heliflieger/Jeti_VarioGPS-Sensor/Arduino/VarioGPS_Sensor/defaults.h

#define MEASURING_INTERVAL        180         //ms
enum
{
  P_GPS_MODE =              1,
  P_GPS_3D =                2,
  P_CURRENT_SENSOR =        3,
  P_CURRENT_CALIBRATION =   4,
  P_CAPACITY_MODE =         5,
  P_ENABLE_RX1 =            6,
  P_ENABLE_RX2 =            7,
  P_ENABLE_TEMP =           8,
  P_ENABLE_COMPASS =        9,
  P_ENABLE_TRAINING =      10,
  P_VARIO_SMOOTHING =      12,
  P_VARIO_DEADZONE =       14,
  P_VARIO_SEALEVELPRESSURE =       15, // 4 Bytes
  P_AIRSPEED_SENSOR =      19,
  P_TEC_MODE =             20,
  P_CAPACITY_VALUE =       26,
  P_VOLTAGE_VALUE =        P_CAPACITY_VALUE+sizeof(float)
};
enum
{
  ID_GPSLAT = 1,
  ID_GPSLON,
  ID_GPSSPEED,
  ID_ALTREL,
  ID_ALTABS,
  ID_VARIO,
  ID_DIST,
  ID_TRIP,
  ID_AZIMUTH,
  ID_COURSE,
  ID_SATS,
  ID_HDOP,
  ID_PRESSURE,
  ID_TEMPERATURE,
  ID_HUMIDITY,
  ID_VOLTAGE,
  ID_CURRENT,
  ID_CAPACITY,
  ID_POWER,
  ID_RX1_VOLTAGE,
  ID_RX2_VOLTAGE,
  ID_EXT_TEMP,
  ID_AIRSPEED,
  ID_SV_SIG_LOSS_CNT,
  ID_SV_SIGNAL_GAP,
  ID_SV_SIGNAL_GAP_MAX,
  ID_SV_SIGNALS_PER_SECOND,
  #ifdef SUPPORT_LSM303
  ID_COMPASS,
  ID_REL_COMPASS,
  ID_TRAINING_ORIENTATION,
  ID_TRAINING_ALTIT,
  #endif
  ID_LAST // not used, but has to be <=32 (see JetiExProtocol.h : MAX_SENSORS)
};
#define RXQ_SIGNAL_PIN 2
#ifndef UNIT_US
JETISENSOR_CONST sensors[] PROGMEM =
{
  #ifdef SUPPORT_GPS
  { ID_GPSLAT,      "Latitude",   " ",          JetiSensor::TYPE_GPS, 0 },
  { ID_GPSLON,      "Longitude",  " ",          JetiSensor::TYPE_GPS, 0 },
  { ID_GPSSPEED,    "GPS speed",  "km/h",       JetiSensor::TYPE_14b, 0 },
  { ID_DIST,        "Distance",   "m",          JetiSensor::TYPE_22b, 0 },
  #ifdef SUPPORT_GPS_EXTENDED
  { ID_TRIP,        "Trip",       "km",         JetiSensor::TYPE_22b, 2 },
  { ID_AZIMUTH,     "Azimuth",    "\xB0",       JetiSensor::TYPE_14b, 0 },
  { ID_COURSE,      "Course",     "\xB0",       JetiSensor::TYPE_14b, 0 },
  { ID_SATS,        "Satellites", " ",          JetiSensor::TYPE_6b,  0 },
  { ID_HDOP,        "HDOP",       " ",          JetiSensor::TYPE_14b, 2 },
  #endif
  #endif
  { ID_ALTREL,      "Rel. Altit", "m",          JetiSensor::TYPE_22b, 1 },
  { ID_ALTABS,      "Abs. Altit", "m",          JetiSensor::TYPE_22b, 0 },
  { ID_VARIO,       "Variometer", "m/s",        JetiSensor::TYPE_22b, 2 },
  { ID_PRESSURE,    "Air press.", "hPa",        JetiSensor::TYPE_22b, 2 },
  { ID_TEMPERATURE, "Temp.",      "\xB0\x43",   JetiSensor::TYPE_14b, 1 },
  #ifdef SUPPORT_BMx280
  { ID_HUMIDITY,    "Humidity",   "%rH",        JetiSensor::TYPE_14b, 1 },
  #endif
  #ifdef SUPPORT_MAIN_DRIVE
  { ID_VOLTAGE,     "Voltage",    "V",          JetiSensor::TYPE_14b, 1 },
  { ID_CURRENT,     "Current",    "A",          JetiSensor::TYPE_14b, 1 },
  { ID_CAPACITY,    "Capacity",   "mAh",        JetiSensor::TYPE_22b, 0 },
  { ID_POWER,       "Power",      "W",          JetiSensor::TYPE_22b, 0 },
  #endif
  #ifdef SUPPORT_RX_VOLTAGE
  { ID_RX1_VOLTAGE, "Rx1 Voltage","V",          JetiSensor::TYPE_14b, 2 },
  { ID_RX2_VOLTAGE, "Rx2 Voltage","V",          JetiSensor::TYPE_14b, 2 },
  #endif
  #ifdef SUPPORT_EXT_TEMP
  { ID_EXT_TEMP,    "Ext. Temp",  "\xB0\x43",   JetiSensor::TYPE_14b, 1 },
  #endif
  #ifdef SUPPORT_MPXV7002_MPXV5004
  { ID_AIRSPEED,    "Air speed",  "km/h",       JetiSensor::TYPE_14b, 0 },
  #endif
  #ifdef SUPPORT_RXQ
  { ID_SV_SIG_LOSS_CNT, "SigLossCnt", "#",      JetiSensor::TYPE_14b, 0 },
  { ID_SV_SIGNAL_GAP,  "SigGap","ms",           JetiSensor::TYPE_22b, 0 },
  { ID_SV_SIGNAL_GAP_MAX,  "SigGapMax","ms",    JetiSensor::TYPE_22b, 0 },
  { ID_SV_SIGNALS_PER_SECOND, "#Sig/Sec","#",   JetiSensor::TYPE_14b, 0 },
  #endif
  #ifdef SUPPORT_LSM303
  { ID_COMPASS,     "Compass",     "\xB0",      JetiSensor::TYPE_14b, 1 },
  { ID_REL_COMPASS, "Rel. Compass","\xB0",      JetiSensor::TYPE_14b, 0 },
  { ID_TRAINING_ORIENTATION, "Training Comp."," ", JetiSensor::TYPE_14b, 0 },
  #endif
  #ifdef SUPPORT_MS5611
  { ID_TRAINING_ALTIT, "Training Altit"," ",       JetiSensor::TYPE_14b, 0 },
  #endif
  { 0 }
};
#endif
#ifdef UNIT_US
JETISENSOR_CONST sensors[] PROGMEM =
{
  #ifdef SUPPORT_GPS
  { ID_GPSLAT,      "Latitude",   " ",          JetiSensor::TYPE_GPS, 0 },
  { ID_GPSLON,      "Longitude",  " ",          JetiSensor::TYPE_GPS, 0 },
  { ID_GPSSPEED,    "GPS speed",  "mph",        JetiSensor::TYPE_14b, 0 },
  { ID_DIST,        "Distance",   "ft.",        JetiSensor::TYPE_22b, 0 },
  #ifdef SUPPORT_GPS_EXTENDED
  { ID_TRIP,        "Trip",       "mi",         JetiSensor::TYPE_22b, 2 },
  { ID_AZIMUTH,     "Azimuth",    "\xB0",       JetiSensor::TYPE_14b, 0 },
  { ID_COURSE,      "Course",     "\xB0",       JetiSensor::TYPE_14b, 0 },
  { ID_SATS,        "Satellites", " ",          JetiSensor::TYPE_6b,  0 },
  { ID_HDOP,        "HDOP",       " ",          JetiSensor::TYPE_14b, 2 },
  #endif
  #endif
  { ID_ALTREL,      "Rel. Altit", "ft",         JetiSensor::TYPE_22b, 1 },
  { ID_ALTABS,      "Abs. Altit", "ft",         JetiSensor::TYPE_22b, 0 },
  { ID_VARIO,       "Variometer", "ft/s",       JetiSensor::TYPE_22b, 2 },
  { ID_PRESSURE,    "Air press.", "inHG",       JetiSensor::TYPE_22b, 2 },
  { ID_TEMPERATURE, "Temp.",      "\xB0\x46",   JetiSensor::TYPE_14b, 1 },
  #ifdef SUPPORT_BMx280
  { ID_HUMIDITY,    "Humidity",   "%rH",        JetiSensor::TYPE_14b, 1 },
  #endif
  #ifdef SUPPORT_MAIN_DRIVE
  { ID_VOLTAGE,     "Voltage",    "V",          JetiSensor::TYPE_14b, 1 },
  { ID_CURRENT,     "Current",    "A",          JetiSensor::TYPE_14b, 1 },
  { ID_CAPACITY,    "Capacity",   "mAh",        JetiSensor::TYPE_22b, 0 },
  { ID_POWER,       "Power",      "W",          JetiSensor::TYPE_22b, 0 },
  #endif
  #ifdef SUPPORT_RX_VOLTAGE
  { ID_RX1_VOLTAGE, "Rx1 Voltage","V",          JetiSensor::TYPE_14b, 2 },
  { ID_RX2_VOLTAGE, "Rx2 Voltage","V",          JetiSensor::TYPE_14b, 2 },
  #endif
  #ifdef SUPPORT_EXT_TEMP
  { ID_EXT_TEMP,    "Ext. Temp",  "\xB0\x46",   JetiSensor::TYPE_14b, 1 },
  #endif
  #ifdef SUPPORT_MPXV7002_MPXV5004
  { ID_AIRSPEED,    "Air speed",  "mph",        JetiSensor::TYPE_14b, 0 },
  #endif
  #ifdef SUPPORT_RXQ
  { ID_SV_SIG_LOSS_CNT, "SigLossCnt", "#",      JetiSensor::TYPE_14b, 0 },
  { ID_SV_SIGNAL_GAP,  "SigGap","ms",           JetiSensor::TYPE_22b, 0 },
  { ID_SV_SIGNAL_GAP_MAX,  "SigGapMax","ms",    JetiSensor::TYPE_22b, 0 },
  { ID_SV_SIGNALS_PER_SECOND, "#Sig/s","#",     JetiSensor::TYPE_14b, 0 },
  #endif
  #ifdef SUPPORT_LSM303
  { ID_COMPASS,     "Compass",     "\xB0",      JetiSensor::TYPE_14b, 1 },
  { ID_REL_COMPASS, "Rel. Compass","\xB0",      JetiSensor::TYPE_14b, 0 },
  { ID_TRAINING_ORIENTATION, "Training Comp."," ", JetiSensor::TYPE_14b, 0 },
  #endif
  #ifdef SUPPORT_MS5611
  { ID_TRAINING_ALTIT, "Training Altit"," ",       JetiSensor::TYPE_14b, 0 },
  #endif
  { 0 }
};
#endif
enum {
  unknown,
  BMP280,
  BME280,
  MS5611_,
  LPS_
};
#define PRESSURE_SEALEVEL         101325   // Pa
#define BMx280_SMOOTHING 0.85
#define BMx280_DEADZONE 5
#define MS5611_SMOOTHING 0.80
#define MS5611_DEADZONE 3
#define MS5611_SEALEVELPRESSURE 101325
#define LPS_SMOOTHING 0.80
#define LPS_DEADZONE 0
enum {
  TEC_disabled,
  TEC_airSpeed,
  TEC_GPS
};
#define AIRSPEED_PIN              A7
#define AIRSPEED_SMOOTHING        0.50
#define UNIVERSAL_GAS_CONSTANT    8.3144621f
#define DRY_AIR_MOLAR_MASS        0.0289644f
enum {
  airSpeed_disabled,
  MPXV7002_MPXV5004
};
#define GPSBaud 9600
enum {
  GPS_disabled,
  GPS_basic,
  GPS_extended
};
#define VOLTAGE_PIN         A1
#define RX1_VOLTAGE_PIN     A2
#define RX2_VOLTAGE_PIN     A3
enum {
  AttoPilot_45V,
  AttoPilot_90V,
  AttoPilot_180V,
  APM25_V,
  ACS712_voltage,
  ACS758_voltage,
  Rx1_voltage,
  Rx2_voltage
};
#ifdef ANALOG_R_DIVIDER_20_20
const uint16_t voltageInputR1[] = {   14700,          14700,          14700,          13700,          10000,          18000,          20000,          20000,  };   //Resistor R1 in Ohms
const uint16_t voltageInputR2[] = {    4700,           1000,           1000,           1500,           1000,           1000,          20000,          20000,  };   //Resistor R2 in Ohms
#else
const uint16_t voltageInputR1[] = {   14700,          14700,          14700,          13700,          10000,          18000,          20000,          20000,  };   //Resistor R1 in Ohms
const uint16_t voltageInputR2[] = {    4700,           1000,           1000,           1500,           1000,           1000,          10000,          10000,  };   //Resistor R2 in Ohms
#endif
#define CURRENT_PIN     A0
enum {
  startup,
  automatic,
  manual
};
#define CAPACITY_SAVE_INTERVAL        10000         // ms
#define MAX_CUR_TO_SAVE_CAPACITY      2             // A
#define VOLTAGE_DIFFERENCE            2             // %
enum {
  mainDrive_disabled,
  AttoPilot_45A,
  AttoPilot_90A,
  AttoPilot_180A,
  APM25_A,
  #if V_REF >= 4500
  ACS712_05,
  ACS712_20,
  ACS712_30,
  #endif
  ACS758_50B,
  ACS758_100B,
  ACS758_150B,
  ACS758_200B,
  ACS758_50U,
  ACS758_100U,
  ACS758_150U,
  ACS758_200U
};
const uint16_t Atto_APM_offset = 0;
const uint16_t ACS_B_offset = V_REF/2; //bi-directional offset in mV ( V_REF / 2)
const uint16_t ACS_U_offset = V_REF/8.33;  //uni-directional offset in mV ( V_REF / 8.33)
const uint8_t mVperAmp[] =  {
                              73,               // AttoPilot 45A
                              37,               // AttoPilot 90A
                              18,               // AttoPilot 180A
                              73,               // APM 2.5 90A
                              #if V_REF >= 4500
                              185,              // ACS712-05
                              100,              // ACS712-20
                               66,              // ACS712-30
                              #endif
                               40,              // ACS758-50B
                               20,              // ACS758-100B
                               13,              // ACS758-150B
                               10,              // ACS758-200B
                               60,              // ACS758-50U
                               40,              // ACS758-100U
                               27,              // ACS758-150U
                               20               // ACS758-200U
                             };
#define TEMPERATURE_PIN     A6
#define THERMISTORNOMINAL   10000
#define TEMPERATURENOMINAL  25
#define BCOEFFICIENT        3950
#define SELF_HEAT           1.2
#define SERIESRESISTOR      10000
#define DEFAULT_GPS_MODE          GPS_disabled          //GPS_disabled, GPS_basic, GPS_extended
#define DEFAULT_GPS_3D_DISTANCE   true
#define DEFAULT_CURRENT_SENSOR    mainDrive_disabled
#define DEFAULT_CAPACITY_MODE     automatic             //startup, automatic, manual
#define DEFAULT_ENABLE_Rx1        false
#define DEFAULT_ENABLE_Rx2        false
#define DEFAULT_ENABLE_EXT_TEMP   false
#define DEFAULT_ENABLE_COMPASS    false
#define DEFAULT_ENABLE_TRAINING_MODE  false
#define DEFAULT_AIRSPEED_SENSOR   airSpeed_disabled
#define DEFAULT_TEC_MODE          TEC_disabled
#define DEFAULT_COMPAS_MIN (LSM303::vector<int16_t>){-731, -711, -256};
#define DEFAULT_COMPAS_MAX (LSM303::vector<int16_t>){+430, +576, +256};
