heliflieger/Jeti_VarioGPS-Sensor/(commit log)

2018-06-03 V2.2.2 01.06.18 Bugfix bei fehlerhaftem #ifdef X || Y -> #if defined(X) || defined(Y) (by RS)
    [VarioGPS_Sensor.ino, defaults.h]
2021-02-19 V2.3.6 19.02.21 priorized telemetry values introduced, now variometer value is transmitted about 10 times/s to reduce the memory footprint, a lot of the sensor values and code fragments are now in #d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
2021-02-23 V2.3.6.1 23.02.21 bug with wrong height values for VarioMS5611 fixed
    [VarioGPS_Sensor.ino, settings.h]
2021-03-01 V2.3.6.2 01.03.21 bugfix JetiExSensor ExBuf overrun fixed (lib added) and usage of new prio-defines
    [VarioGPS_Sensor.ino, settings.h]
2021-04-03 V2.3.6.3 03.04.21 bugfix do the ms5611.run() only if MS5611 is detected
    [VarioGPS_Sensor.ino]
2022-12-27 Version 2.4 * Unterstützung eines GY-511 (LSM303) Kompass-Modules. Angezeigt wird dr absolute und der relative Wert, seit dem Start. * Fix some code problems
    [HandleMenu.h, VarioGPS_Sensor.ino, defaults.h, settings.h]
2022-12-28 Fix Ex-Bus Add compiled images
    [VarioGPS_Sensor.ino, settings.h]
2023-01-06 Kompass GX-511 hinzugefügt, Trainingswerte und Luftdruck auf Meereshöhe einstellbar
